ali1140/Deteksi-dini-jamur-ganoderma-sawit-dengan-ESP32-Sensor-PH-Kelembaban-Suhu/screenshot.png

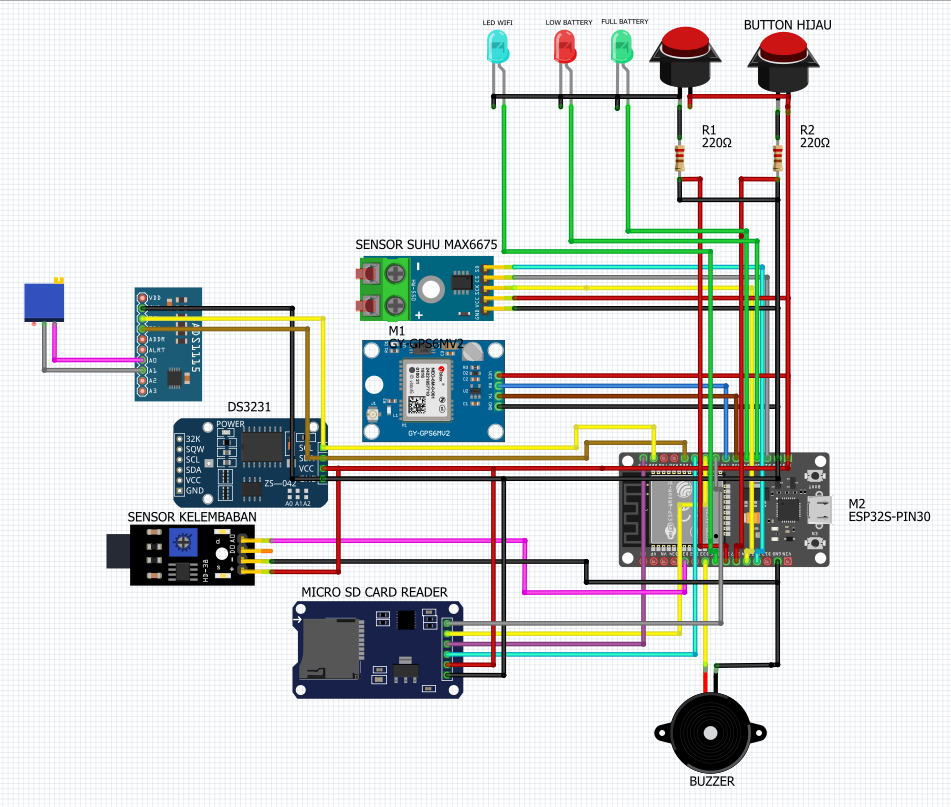
screenshot.png
